LasPastillasDelAbuelo/LasPastillasDelAbuelo/(commit log)

2018-11-28 Se agrega el código de arduino
    Se agrega el código de arduino
2018-11-28 Actualización de bibliotecas
    Se eliminan bibliotecas no utilizadas
2018-11-28 Declaración Pin de Botón
    Se actualizó el pin del botón
2018-11-29 Se actualiza el diagrama de Firmware
